garubi/MIDI-Drawbars-Commander/enclosure/layout drawbar controller.pdf

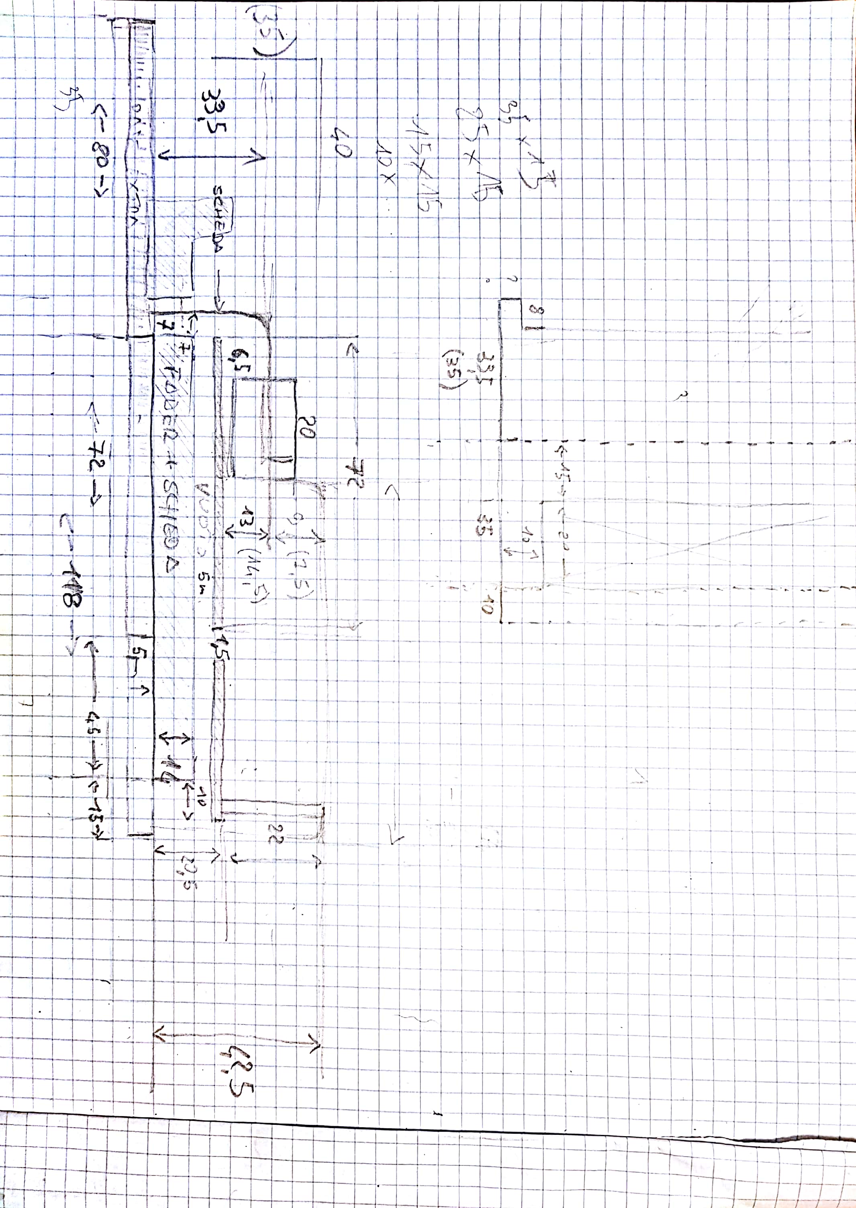
[picture p1: page 1]

Scanned by CamScanner
