garubi/MIDI-Drawbars-Commander/(threads)

Thread 2 (2018-07-04):

implement MIDI thru/merge

garubi, 2018-07-04:
tips:

- https://forum.pjrc.com/threads/52740-Passing-midi-data-from-MidiUSB-to-Midi-out-on-TX-pin-(Teensy-3-2)
- https://forum.pjrc.com/threads/32384-Teensy-3-1-Midi-USB-Interface-1-in-2-Out-Thru-(split)-Midi-Controller/page2
- https://forum.pjrc.com/threads/32384-Teensy-3-1-Midi-USB-Interface-1-in-2-Out-Thru-(split)-Midi-Controller/page2

garubi, 2018-07-04:
Started working on this in branch midi-merge
But can't compile... propbably I have to update teensyduino and maybe the usbMidi library

Closed 2018-07-05.

Thread 8 (2018-07-04):

In STATUS_ALT the first 6 leds don't turn on

garubi, 2018-07-04:

garubi, 2018-07-04:
the problem happens only when the buttons is set as IS_GLOBAL

garubi, 2018-07-04:
since IS_GLOBAL and SEND_ALL doesn't make sense in ALTERNATE mode, I remove them

Closed 2018-07-04.

Thread 9 (2018-07-04):

The Presets leds doesn't turn ON

garubi, 2018-07-04:

garubi, 2018-07-04:
fixed!

Closed 2018-07-04.

Thread 14 (2018-07-09):

blink current preset LED when Midi In activity occurs

garubi, 2018-07-09:
But only if this doesn't slow down the MIDI MERGE

Closed 2019-01-05.

Thread 23 (2018-08-09):

Sometimes Teensy reboot when Plug/Unplug the expression pedal jack

garubi, 2018-08-09:
possible solution:
https://forum.pjrc.com/threads/29145-Little-problem

Closed 2018-08-10.

Thread 24 (2018-09-24):

The switch pedal triggers on pedal release: it should be on pedal press

garubi, 2018-09-24:

garubi, 2018-10-08:
it could be caused by a swapped soldering in jack input

Closed 2018-10-31.

Thread 25 (2018-10-08):

We could provide some MIDI mapping/filtering on Midi IN

garubi, 2018-10-08:

garubi, 2018-11-08:
example use case:

- attach to MIDI IN a 2nd (lower) keyboard and route all it's events to channel 2

Thread 31 (2018-10-29):

Midi Merge / Midi Thru introduce noticebale latency

garubi, 2018-10-29:

garubi, 2018-10-30:
Probably we should refactor the code in the loop, but first we could try some things:
- check if all that SerialPrint have something to do with it
-- try faster baudrate
-- remove all the serialprint() (maybe use something like
`#define DEBUG false

// conditional debugging
#if DEBUG

  #define beginDebug()  do { Serial.begin (115200); } while (0)
  #define Trace(x)      Serial.print   (x)
  #define Trace2(x,y)   Serial.print   (x,y)
  #define Traceln(x)    Serial.println (x)
  #define Traceln2(x,y) Serial.println (x,y)
  #define TraceFunc()   do { Serial.print (F("In function: ")); Serial.println (__PRETTY_FUNCTION__); } while (0)

#else
  #define beginDebug()  ((void) 0)
  #define Trace(x)      ((void) 0)
  #define Trace2(x,y)   ((void) 0)
  #define Traceln(x)    ((void) 0)
  #define Traceln2(x,y) ((void) 0)
  #define TraceFunc()   ((void) 0)
#endif // DEBUG`

garubi, 2018-11-05:
maybe try to enable running status in the MIDI library

garubi, 2018-11-07:
lot of interesting info about the midi ibrary here:
https://github.com/FortySevenEffects/arduino_midi_library/issues/71

garubi, 2018-11-17:
Greatly reduced the latency.
It's well playable with piano and fast-attack sounds too.
We can close this.

Closed 2018-11-17.

Thread 34 (2018-11-05):

when switch to ALT status, it sends out lot of Serial print about button press...

garubi, 2018-11-05:

garubi, 2018-11-05:
missing parentesis introduced in commit #8343f549e5fb4e6774a1365ee1bdf4bd9cbf8270

Closed 2018-11-05.

Thread 35 (2018-11-06):

Wrong LEDS on/Off on presets change

garubi, 2018-11-06:
the default values are set ok but the preset change leds are wrong
working on this in pull request #33

Closed 2018-11-07.

Thread 37 (2018-11-07):

Build an interface to program/reprogram the PRESETS an dstore them in eeprom

garubi, 2018-11-07:
This would require additional hardwarae: a I2C eeprom, since the TeensyLC eeprom is too small to store even 1 of the 4 presets.

We can build an editor using CTRLC (standaolne or VST) and sending the configuration as SysEX or NRPN

garubi, 2018-11-07:
All you need to know about RPN and NRPN:
http://www.philrees.co.uk/nrpnq.htm

if we choose to use NRPN this issue contains an useful Library and lot of useful consideration:
FortySevenEffects/arduino_midi_library#60

Thread 43 (2018-11-12):

The ALT button's led doesn't pass from Low to Hight anymore

garubi, 2018-11-12:

garubi, 2018-11-13:
introduced with the IF() code relates to issue #42 bug introduced in commit https://github.com/garubi/Drawbarsy-9/commit/c6aee8e2420c43e0757a8257f77e6c904da204b5
The code compares the ALT_LED value for the current status but it's always the same for each status thus it doesn't pass the if(is_the_leds_byte_changed) check.

garubi, 2018-11-14:
fixed by dropping the first bit (corresponding to the ALT_LED) when doing the check

Closed 2018-11-15.

Thread 48 (2018-11-16):

A momentary button can't be identified as momentary if also is set as IS_GLOBAL or SEND_BOTH etc

garubi, 2018-11-16:
Since we assume tha a Momentary button as BEHAV = 0, if we add to it IS_GLOBAL or SEND_BOTH how we can then read 0?
Maybe I'm missing something with bitmasking (have to check)
If really it is like reported than we have to introduce IS_MOMENTARY

Closed 2019-01-15.

Thread 51 (2018-12-06):

When on Preset 0, the analogue sync doesn't start

garubi, 2018-12-06:

garubi, 2019-01-04:
it is because on the preset 0 the "vib-on" button (that is that who trigger the analog sync) is disabled (set to TP_NO) thus no action is triggered

Closed 2019-01-04.

Thread 58 (2019-01-07):

Midi thru outputs spurious midi messages via usb

garubi, 2019-01-07:
UPDATE:
It's not the thru feature that has problems.
It's the MIDI IN interface that has hardware problems.
Ging to fix it.
Schematic already updated

garubi, 2019-01-08:
Tested din in din out
No spurious messages.
So it could be a problem just from din midi in to usb mid out

garubi, 2019-01-16:
Performed new tests: the wrong midi messages are coming from the (din) MIDI IN
Asked for help on the teensy forum
https://forum.pjrc.com/threads/54891-MIDI-serial-(DIN)-to-usbMIDI-issues-got-weird-MIDI-messages

Looks like that there are issues on the MIDI IN hardware part.
Needs further investigation

garubi, 2019-03-27:
I checked the perfboard and the components.
Components are wrong and the connections too.
I recreated the right MIDI IN port on the Breadboard.
Now I have to dismantle and redo the MIDI IN on the Commander perfboard.

I Updated the schematic with the right components and connections:
https://github.com/garubi/MIDI-Drawbars-Commander/tree/master/schematic

garubi, 2019-04-03:
Resoldered the perfboard, pdated again the schematic. close the issue

Closed 2019-04-03.

Thread 59 (2019-02-11):

When in LOWER "set", the switch pedal sends the wrong message

garubi, 2019-02-11:
Is sends the MIDI message related to LESLIE STOP (it should be LESLIE FAST)

garubi, 2019-03-11:
it's because it reads the settings for the LOWER status

Closed 2019-03-12.

Thread 60 (2019-03-04):

in bank 0 (Roland FA) Leslie Velocity is assigned to Leslie STOP. ANd sSTop is assigned Wrong...

garubi, 2019-03-04:

Closed 2019-03-12.
