garubi/MIDI-Drawbars-Commander/schematic/schematic.pdf

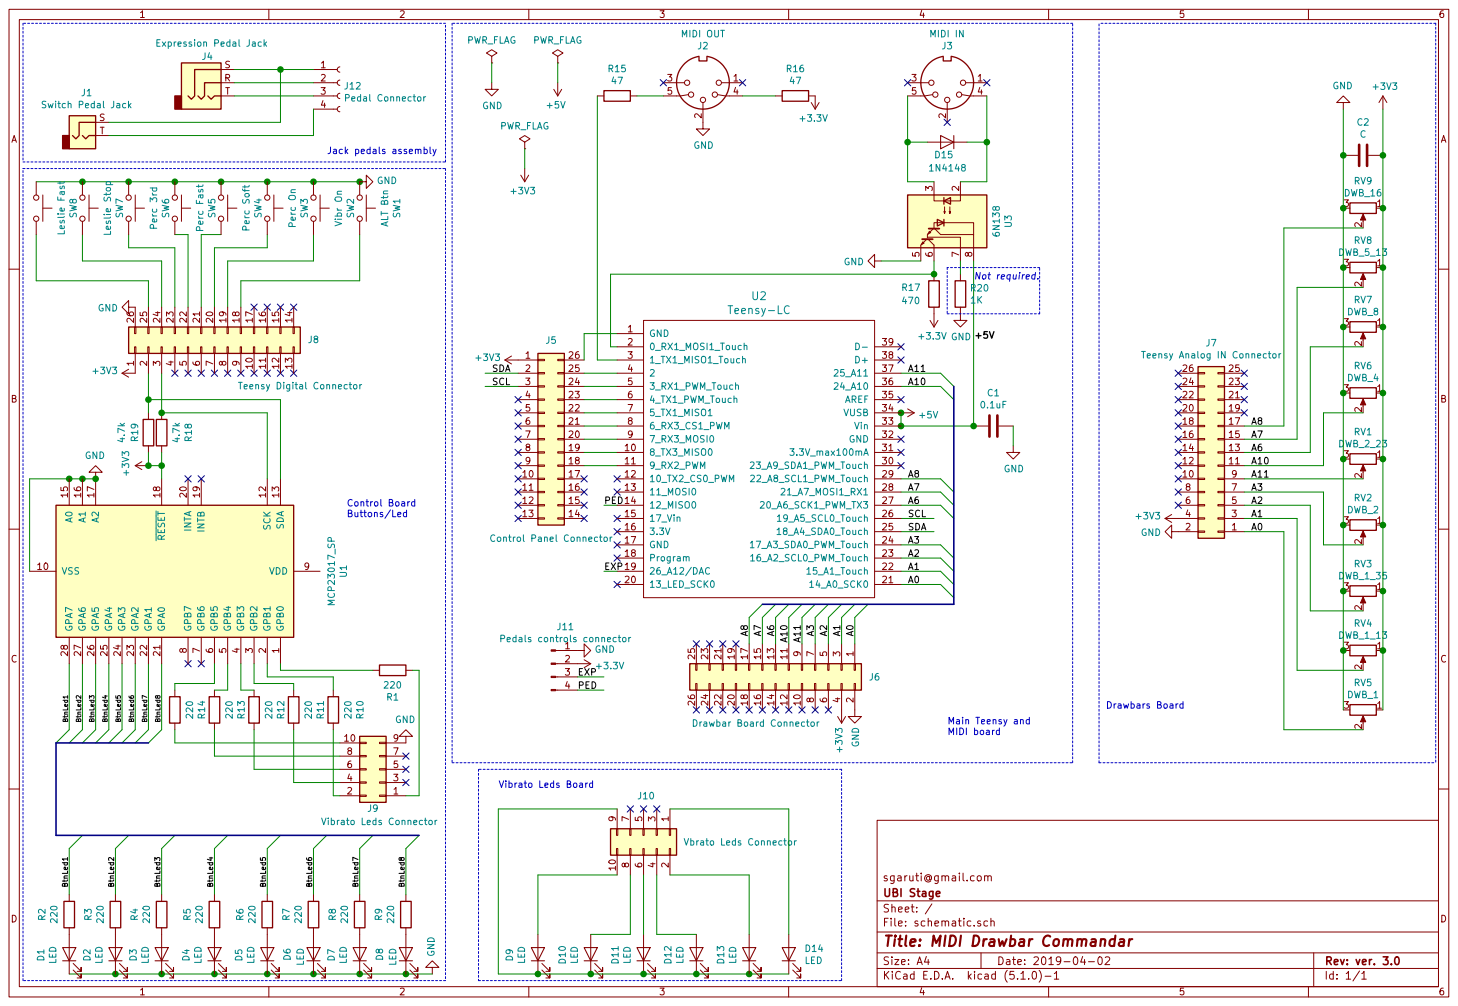
[picture p2: page 1]

Jack pedals assembly Control Board Buttons/Led

J7 Teensy Analog IN Connector GND

1 VSS 10 SCK 12 SDA 13 A0 15 A1 16 A2 17 RESET 18 INTB 19 GPB1

8 VDD 9 U1 MCP23017_SP D14 D10 LED D11 LED D12 LED D13 LED

J9 Vibrato Leds Connector GND GPB0

J11 Pedals controls connector GND

sgaruti@gmail.com
Id: 1/1 Title: MIDI Drawbar Commandar File: schematic.sch Sheet: / UBI Stage
