garubi/MIDI-Drawbars-Commander/enclosure/labels.pdf

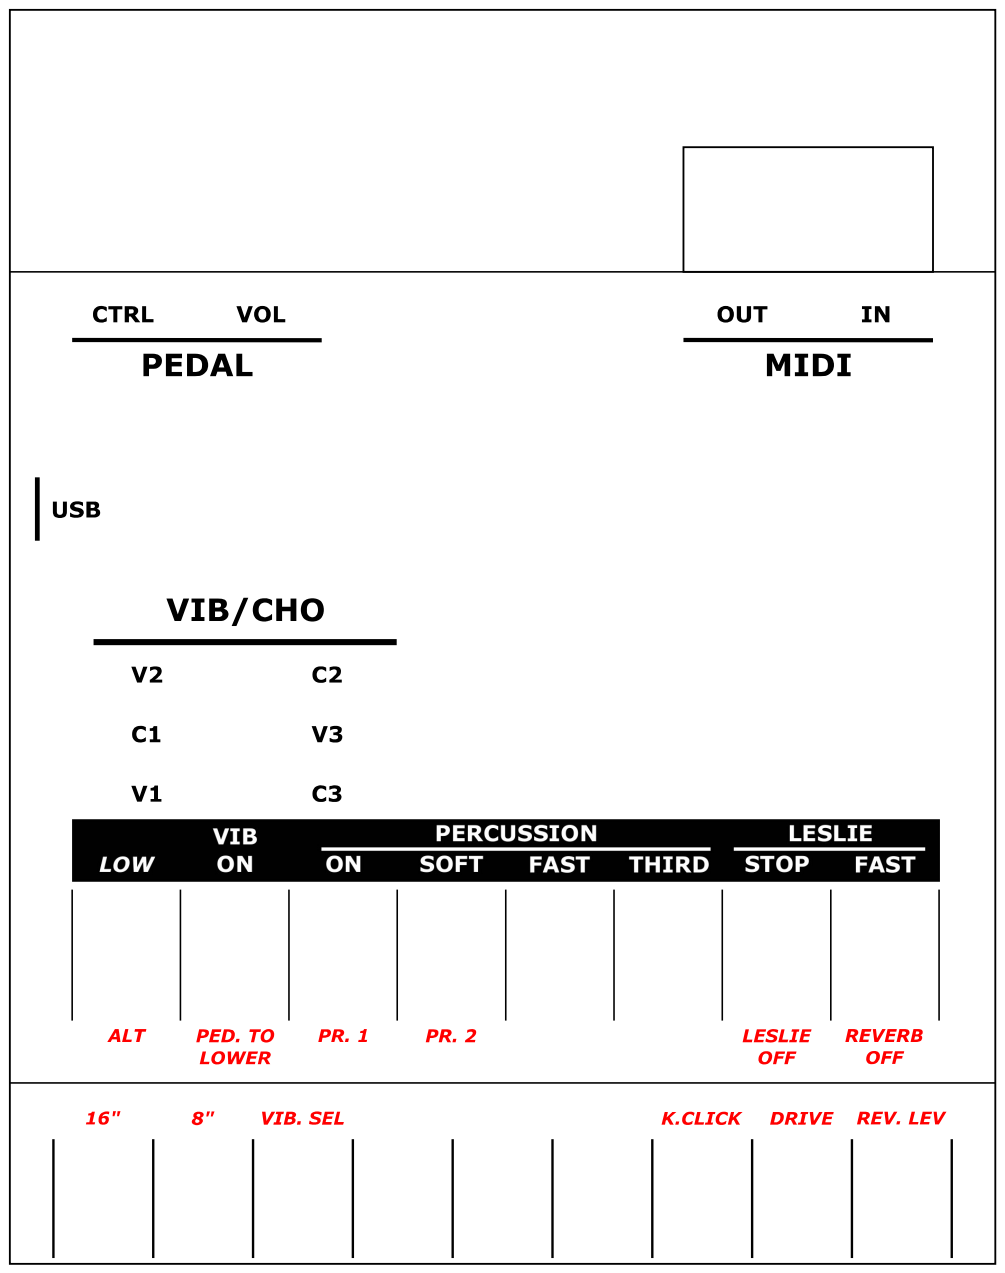
[picture p3: page 1]
