garubi/MIDI-Drawbars-Commander/(commit log)

2018-07-04 Adds Presets switching ability
2018-07-04 Fix warnong about comparing between signed and unsigned
    [D9-drawbars-controller.ino]
2018-07-04 code to send all received midi from DIN MIDI IN
    can't compile.
    Probably need to update teensyduino and MIDI library
2018-07-04 Fix issue #8
    Definitively don't allow IS_GLOBAL and send_ALL in ALTERNATE mode. Removed them from the presets array too
    [D9-drawbars-controller.ino]
2018-07-05 adds compatibility with Teensyduino 1.42 with updated MIDI Library
2018-07-05 fix issue #1 - now sends commands on the channel specified in preset
    [D9-drawbars-controller.ino]
2018-07-05 remove any reference to 'preset' variable in ResponsiveAnalog setup. Working on issue #7
    [D9-drawbars-controller.ino]
2018-07-05 do not track compiled files
2018-07-05 Fix buttons definition
2018-07-06 Set the device's USB name. close issue #10 (#12)
    [name.c]
2018-07-23 Analog sync and startup default setup (#15)
    * create the function that sync at any time the analog reads
    Use this at startup
    * set starting data
    * Ok analog Sync
    * FIX Setting initial values
    * Adds Led feedback on AnalogSync
    Blinck all the leds in sequence
    * fix issue on startup data not following the status
    * ather changes to the startup defaults. Still the presets seems to be wrong
    * removed debug code
    [D9-drawbars-controller.ino]
2018-07-23 Handle default data at startup and the preset switching (#18)
    * remove unused MIDI message types
    Pitch bend and aftertouch are hardly used in such a controller.
    Remove them to make space for the "is_preset" type
    * USe the new TYPE "IS_PRESET"
    * Set and use Constants for MIDI message types
    * Enable the analog data sync
    * Don't process disabled buttons
    * Don't process disabled drawbars
    * close issu#9 - manage presets initiallisation and default data
    * house cleaning...
2018-07-24 Set the right Vib/Cho led on at startup. (#19)
    * set Vib/Cho at startup at C3 (127);
    addressing issue #16
    * Only read settings in PRESET[0] to detrmine the presets
    * cleanup...
    [D9-drawbars-controller.ino]
2018-08-09 Scan the Pedals: address issues #3 & #4 (#21)
    * first (failed) attempt to enable the pedal switch
    * Check the Pedal switch too, but don't toggle any led
    * Enable the analog input for expression pedal
    * Support SEND_ALL and IS_GLOBAL in analog too
    * Support SEND_ALL and IS_GLOBAL in analog sync too
    * Create SetAltLedState(); Add named constants vor leds, reduce the clutter,
    its working
    * added some TODO
    * Add some code documentation
    [D9-drawbars-controller.ino]
2018-08-09 Set the time a button is "long-pressed" to 1300 millis
2018-10-09 Update D9-drawbars-controller.ino (#30)
    uses updateBtn() for the non-toggles buttons too. fix issue #28
    [D9-drawbars-controller.ino]
2018-10-30 Fix a wrong count in loading default present on device setup
    [D9-drawbars-controller.ino]
2018-10-31 Uses fixed Preset Buttons
    [D9-drawbars-controller.ino]
2018-11-02 fix Led on/off and Preset buttons detection
    [D9-drawbars-controller.ino]
2018-11-05 function isPresetButton(btn_scanned) to check if is a preset button
2018-11-06 issue #29: fix problems with settings
    [D9-drawbars-controller.ino]
2018-11-07 fix issue #35 about wrong leds on Preset change
    [D9-drawbars-controller.ino]
2018-11-07 fix comments and some code reordering
    [D9-drawbars-controller.ino]
2018-11-07 Fix bug: wrong declaration order
    [D9-drawbars-controller.ino]
2018-11-09 moved btn_leds status to bit() so I can use just 1 Byto for them all. workinh on issue #41
    [D9-drawbars-controller.ino]
2018-11-09 Fix wrong constant used :-(
    [D9-drawbars-controller.ino]
2018-11-09 Set all leds in only one call. Extending this to VibCho leds too. issue #41
    [D9-drawbars-controller.ino]
2018-11-09 Update Leds only if something is changed. issue #41
    [D9-drawbars-controller.ino]
2018-11-09 fix some errore. seems to fix issue #42. issue #41 need still some working
    [D9-drawbars-controller.ino]
2018-11-12 Move setting of vibchoLedState_old so that it's correctly evaluated. Various code cleanups
    [D9-drawbars-controller.ino]
2018-11-13 fix error in updating VibCho Leds
    [D9-drawbars-controller.ino]
2018-11-14 streamline the Leds settings
2018-11-14 remove wrong code from another branch
    [D9-drawbars-controller.ino]
2018-11-15 tested fix to issue #43
    [D9-drawbars-controller.ino]
2018-11-15 Revert "Merge branch 'master' into conditional-led-sendig"
    This reverts commit 23ecb16aada9eb44c94ad8ed5d1b4a95e5932a90, reversing
    changes made to 7c5f7d6bfb5f7ebfb2008ba534a87874c351ee30.
2018-11-15 New Led management (#46)
    * moved btn_leds status to bit() so I can use just 1 Byto for them all. workinh on issue #41
    * Fix wrong constant used :-(
    * Set all leds in only one call. Extending this to VibCho leds too.
    issue #41
    * Update Leds only if something is changed. issue #41
    * fix some errore. seems to fix issue #42. issue #41 need still some working
    * Move setting of vibchoLedState_old so that it's correctly evaluated. Various code cleanups
    * fix error in updating VibCho Leds
    * fix issue #43
    * tested fix to issue #43
    * Revert "Merge branch 'master' into conditional-led-sendig"
    changes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
    [D9-drawbars-controller.ino]
2018-11-15 Simplify toggle button (#47)
2018-11-15 Fix wrong old_preset_led index
    [D9-drawbars-controller.ino]
2018-11-19 ver. 1.3. close issue #31; close issue #41; close issue #42; close issue #43
    [D9-drawbars-controller.ino]
2018-11-19 let specify that the Switch pedal has to turn on/off a "linked" button's LED. close issue #26 (#49)
    * proof of concept of controlling a btnLed from pedal switch
    * implement the Pedal swith -> button ALias
    * implement led control by switch pedal. close issue #26
    * better documentation: prepare for merge
    * close issue #26
    [D9-drawbars-controller.ino]
2018-11-19 update device name
2018-11-19 fix BUG in device's name.
    [name.c]
2019-01-04 close issue #52
    close issue #52
    [D9-drawbars-controller.ino]
2019-01-04 Close #51 issue
    Close #51 issue
    [D9-drawbars-controller.ino]
2019-01-05 Blink midi activity (#57) close #14
    * implement led blinking on MIDI IN activity.
    blinks the current preset's LED
    * Update D9-drawbars-controller.ino
    Fix some wrong assumption here...
    * A further step... sometimes something is blinking
    * close #14 - blink preset's LED on MIDI in activity
    ignore invalit MIDI messages and Active Sensing (but still forward them)
    [D9-drawbars-controller.ino]
2019-01-05 v1.3.4 Blinks preset's LED on MIDI in activity
2019-03-11 Update D9-drawbars-controller.ino
    fix issue #60 : wrong LEslie CC assign for Roland FA
    fix the Drive CC assign too
    [D9-drawbars-controller.ino]
2019-03-11 Update D9-drawbars-controller.ino
    fix issue #61 , fix issue #62
    assign FA more controls: Leslie Off and Keyclick Level
    [D9-drawbars-controller.ino]
2019-03-21 add kicad schematic
    [midi-commander-schematic.kicad_pcb, midi-commander-schematic.sch]
2019-03-21 New project files layout
    [schematic.kicad_pcb, schematic.sch]
2019-03-27 Updated with not required resistor to reflect the real perfboard
    [schematic.sch]
2019-04-03 New schematic version (#67)
    With all the connectros and the right pin-connectors order
    [schematic.sch]
2020-02-06 version 1.3.6 - new Gemini MIDI map
    Avoid conflict with FA Roland
    [D9-drawbars-controller.ino]
2020-04-22 fix issue #70 - vibrato selector problem
    [D9-drawbars-controller.ino]
